SorX14/Tank/Arduino/ControllerBoard_v1/Notes 300814.md

Notes
====

### ESC
- Configuring ESC for forward and backward motion
- Created a configuration mode for the ESCs
- Found the minimum and maximum microseconds of the ESC and set via `Servo.writeMicroseconds()`
- Used servo to help diagnose XRF library

### CRC32 implementation

### Python
