SorX14/Tank/control.jpg

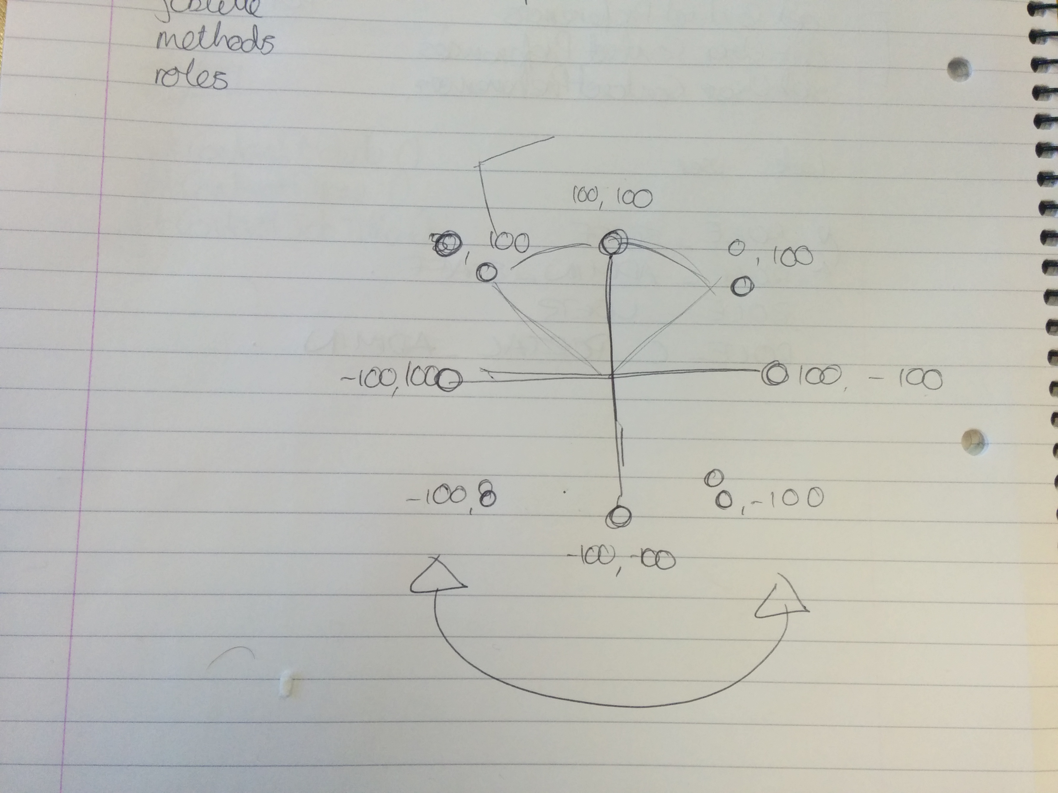
control.jpg
