SorX14/Tank/PCB/Connector board/bottom.png

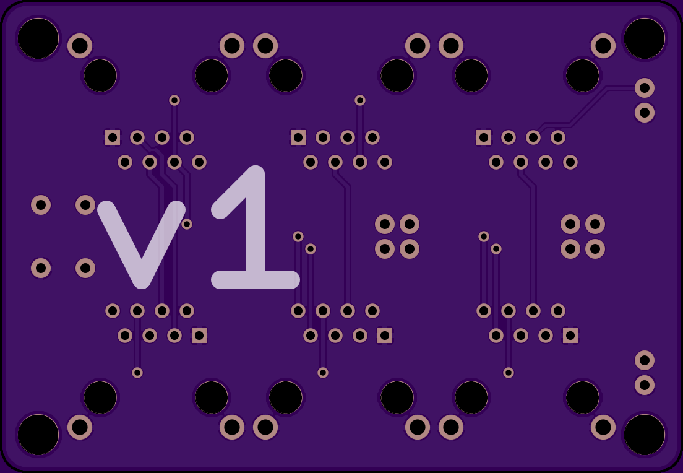
PCB/Connector board/bottom.png
