SorX14/Tank/PCB/Connector board/schematic.png

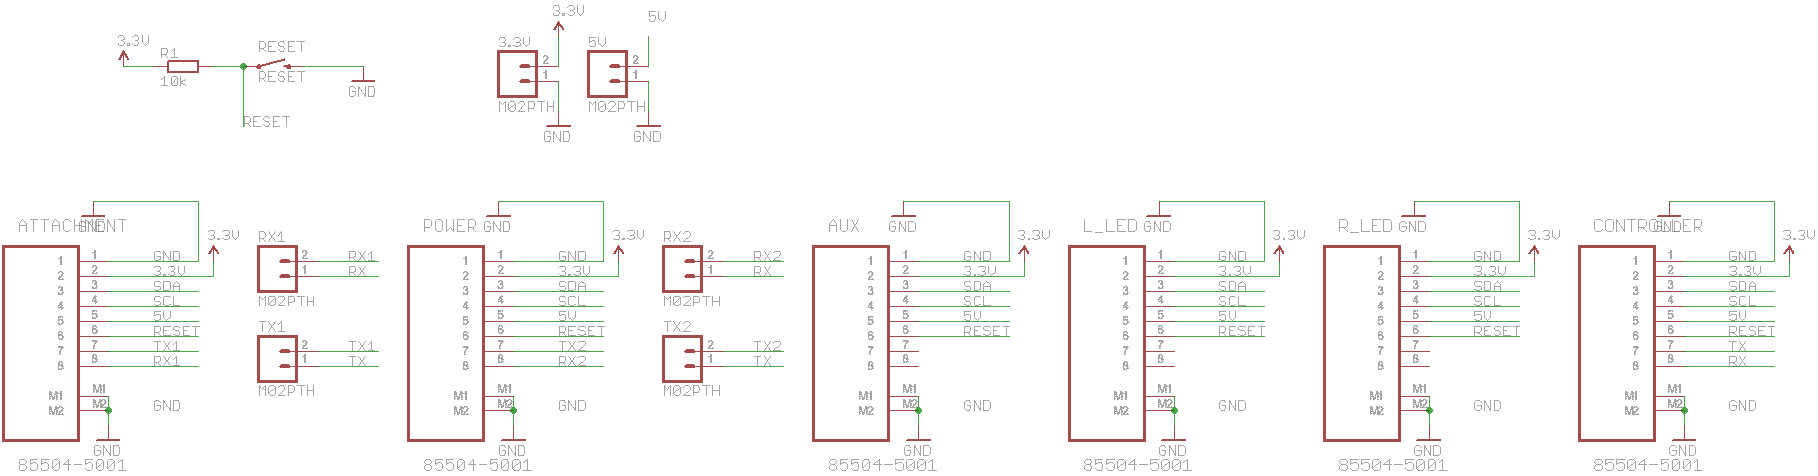
PCB/Connector board/schematic.png
