SorX14/Tank/PCB/Connector board/top.png

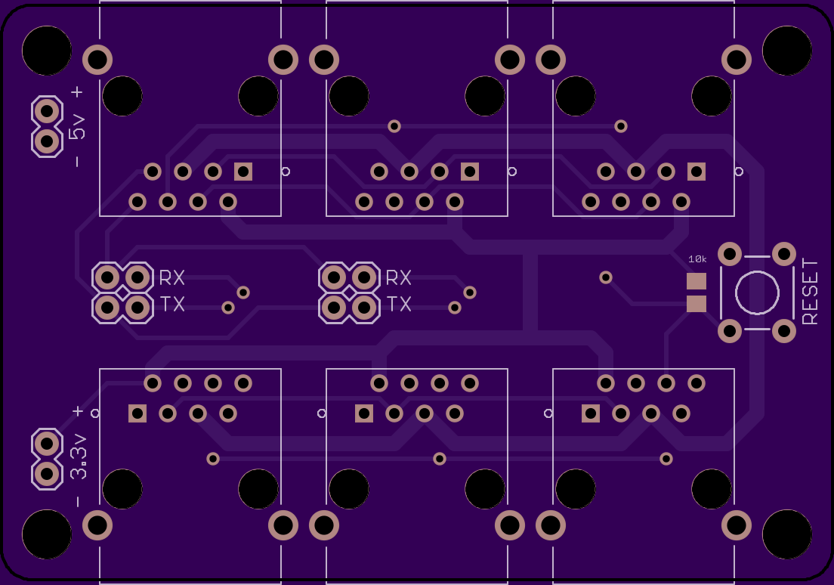
PCB/Connector board/top.png
