SorX14/Tank/PCB/Controller board/bottom.png

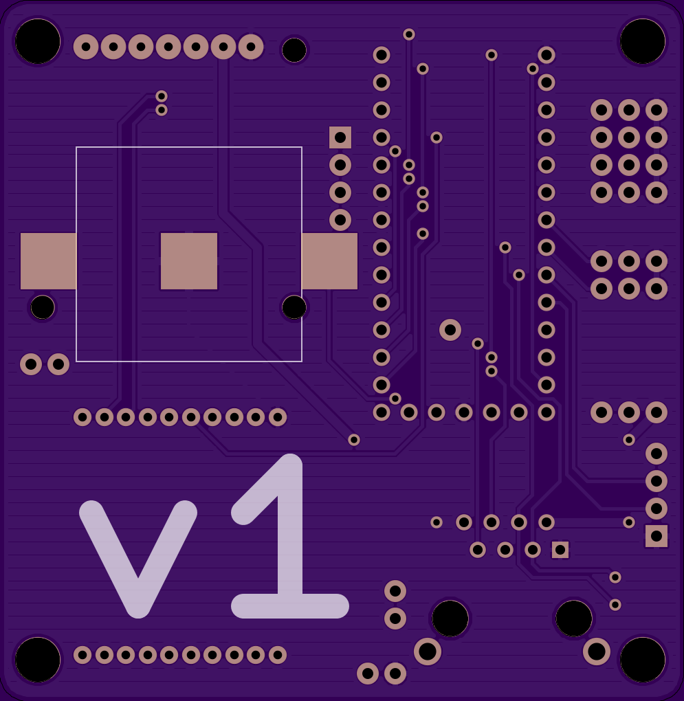
PCB/Controller board/bottom.png
