SorX14/Tank/PCB/Controller board/schematic.png

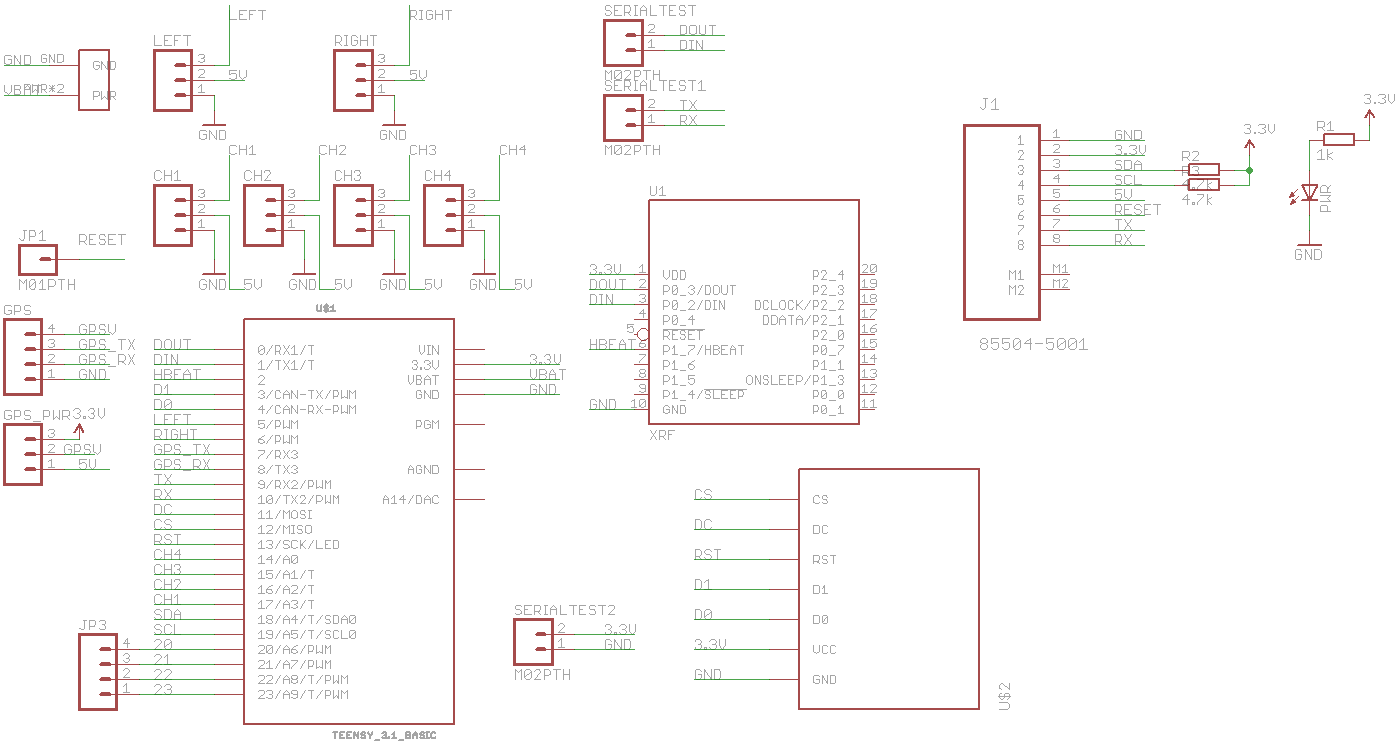
PCB/Controller board/schematic.png
