SorX14/Tank/PCB/Controller board/top.png

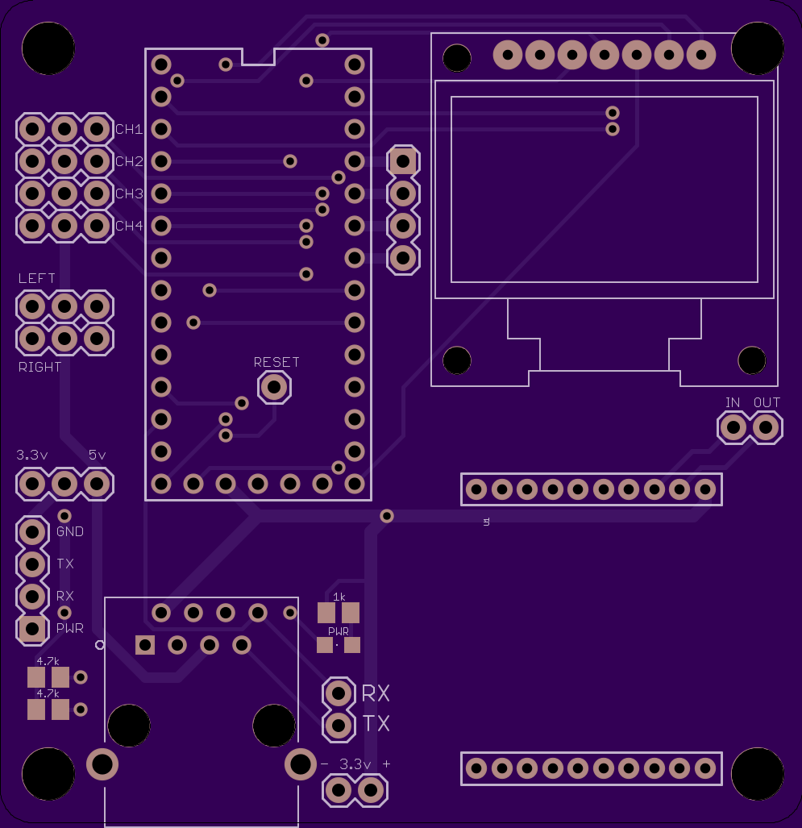
PCB/Controller board/top.png
