SorX14/Tank/PCB/LED board/bottom.png

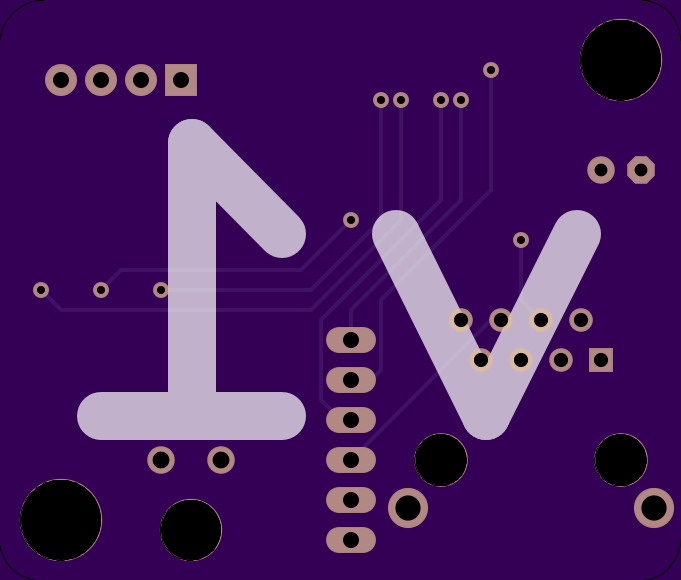
PCB/LED board/bottom.png
