SorX14/Tank/PCB/LED board/schematic.png

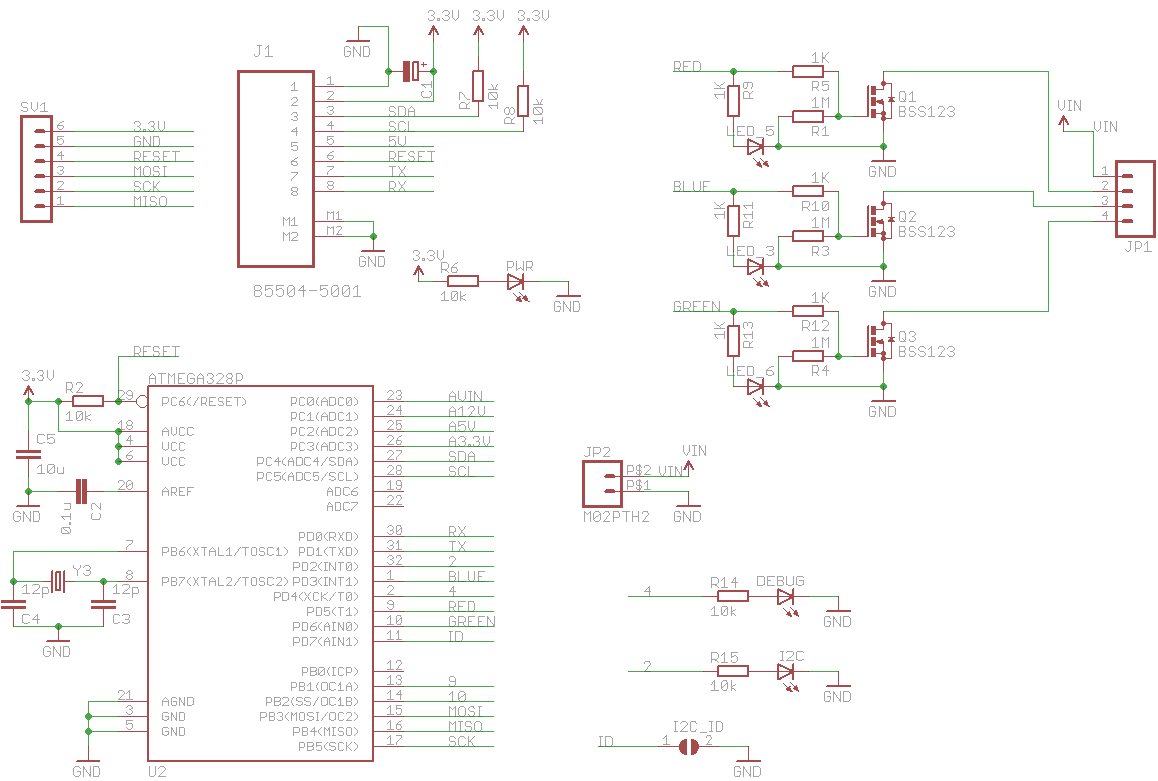
PCB/LED board/schematic.png
