SorX14/Tank/PCB/LED board/top.png

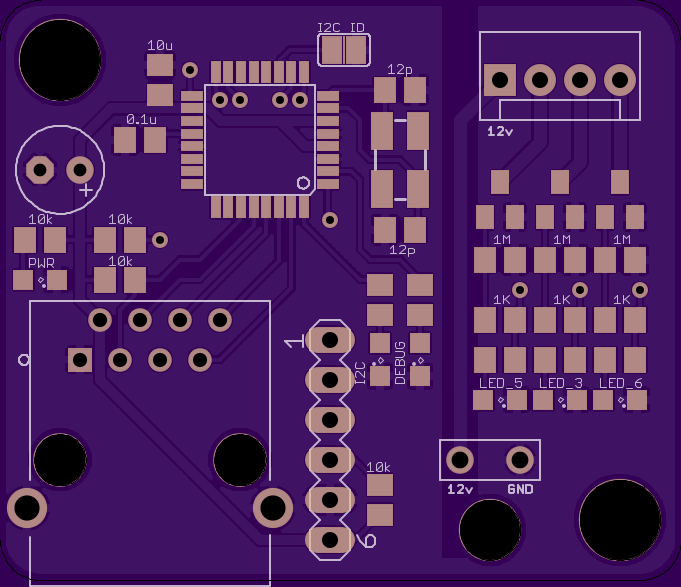
PCB/LED board/top.png
