SorX14/Tank/PCB/Power board/bottom.png

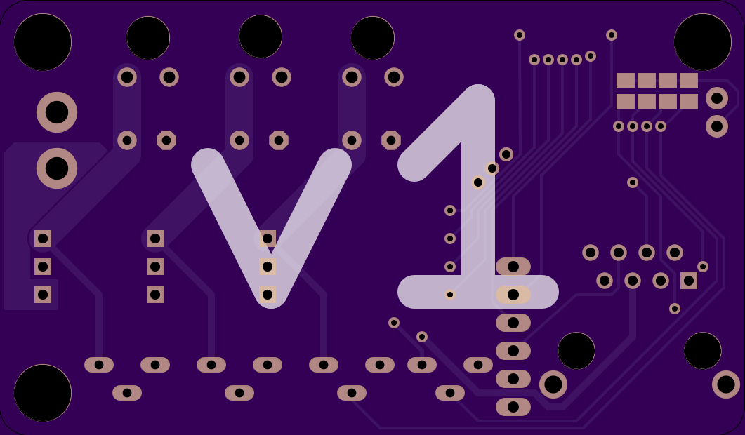
PCB/Power board/bottom.png
