SorX14/Tank/PCB/Power board/schematic.png

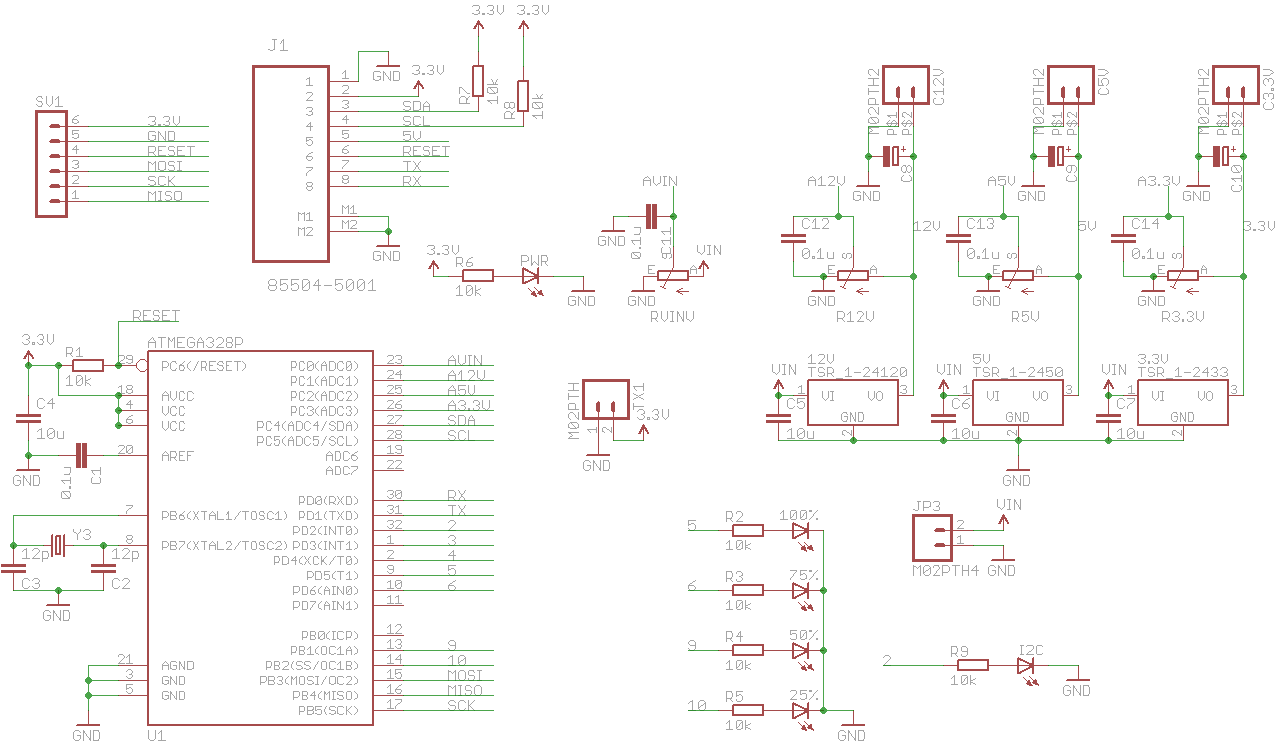
PCB/Power board/schematic.png
