SorX14/Tank/PCB/Power board/top.png

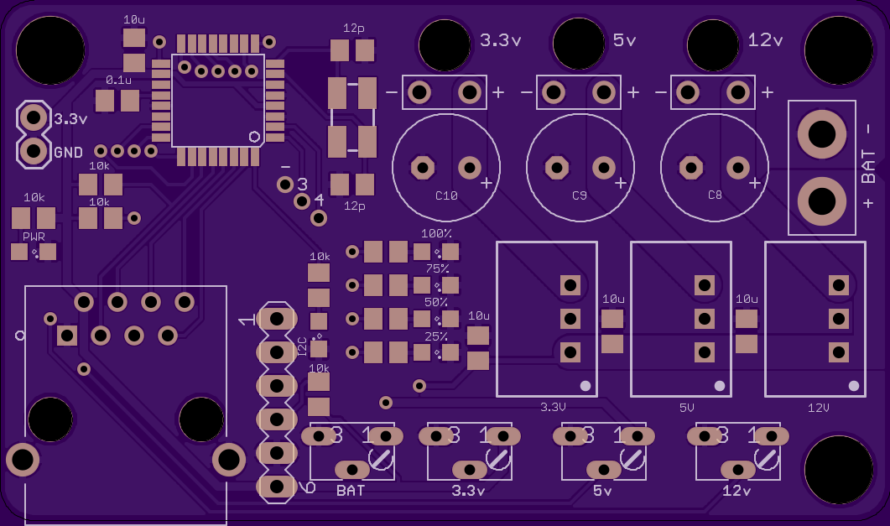
PCB/Power board/top.png
