SorX14/Tank/Arduino/ControllerBoard_v1/ESC calibration.md

ESC calibration
===========

Calibrating Hobbywing XERUN 150A ESC

1. Switch off ESC
2. Hold `SET` key and switch ESC on
	1. Red LED begins to flash
3. Move throttle to **neutral** point and press `SET`
	-  Green LED flashes once
4. Move throttle to 100% **forward** and press `SET`
	- Green LED flashes twice
5. Move throttle to 100% **backward** and press `SET`
	- Green LED flashes three times
6. Throttle range calibration complete, after 3 seconds the ESC is ready to use
