SorX14/Tank/PCB/Connector board/v1.brd

## EAGLE design PCB/Connector board/v1.brd (2014-07-21, an earlier design)

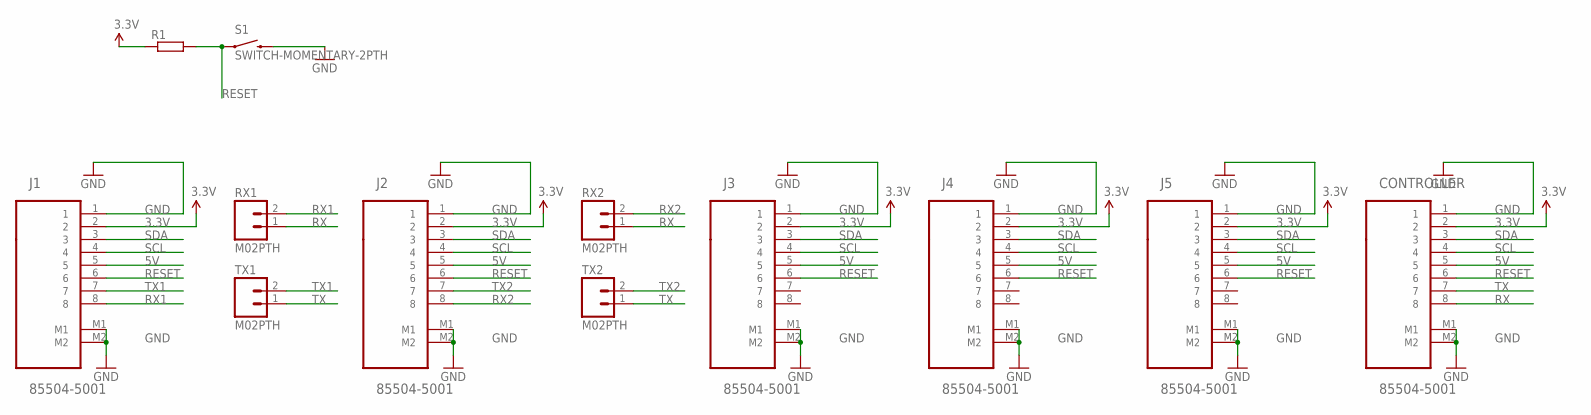
[picture p15: schematic v1.sch]

Parts:
CONTROLLER: 85504-5001; MOLEX_85504-5001
J1, J2, J3, J4, J5: 85504-5001; MOLEX_85504-5001
R1: R-EU_R0805; R0805
RX1, RX2: M02PTH; 1X02
S1: SWITCH-MOMENTARY-2PTH; TACTILE-PTH
TX1, TX2: M02PTH; 1X02

Connections:
3.3V: CONTROLLER.2, J1.2, J2.2, J3.2, J4.2, J5.2, R1.1
5V: CONTROLLER.5, J1.5, J2.5, J3.5, J4.5, J5.5
GND: CONTROLLER.1, CONTROLLER.M1, CONTROLLER.M2, J1.1, J1.M1, J1.M2, J2.1, J2.M1, J2.M2, J3.1, J3.M1, J3.M2, J4.1, J4.M1, J4.M2, J5.1, J5.M1, J5.M2, S1.3 (2)
RESET: CONTROLLER.6, J1.6, J2.6, J3.6, J4.6, J5.6, R1.2, S1.1
RX: CONTROLLER.8, RX1.1, RX2.1
RX1: J1.8, RX1.2
RX2: J2.8, RX2.2
SCL: CONTROLLER.4, J1.4, J2.4, J3.4, J4.4, J5.4
SDA: CONTROLLER.3, J1.3, J2.3, J3.3, J4.3, J5.3
TX: CONTROLLER.7, TX1.1, TX2.1
TX1: J1.7, TX1.2
TX2: J2.7, TX2.2

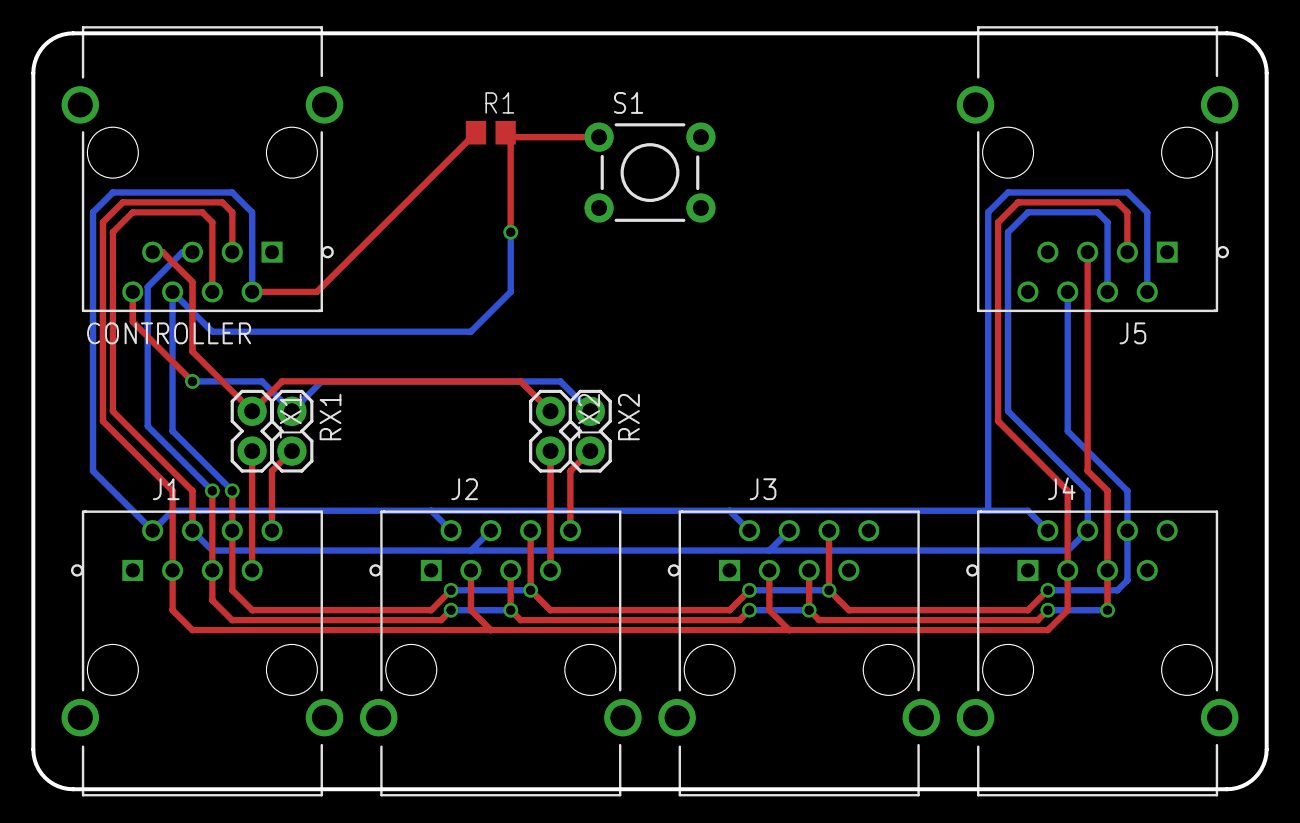
[picture p16: board PCB/Connector board/v1.brd from above]

Board: 2 copper layers, 78.7 x 48.3 mm, 12 parts (0 on the bottom side), 12 nets.
