SorX14/Tank/PCB/Power board/v1.brd

## EAGLE design PCB/Power board/v1.brd (2014-07-21)

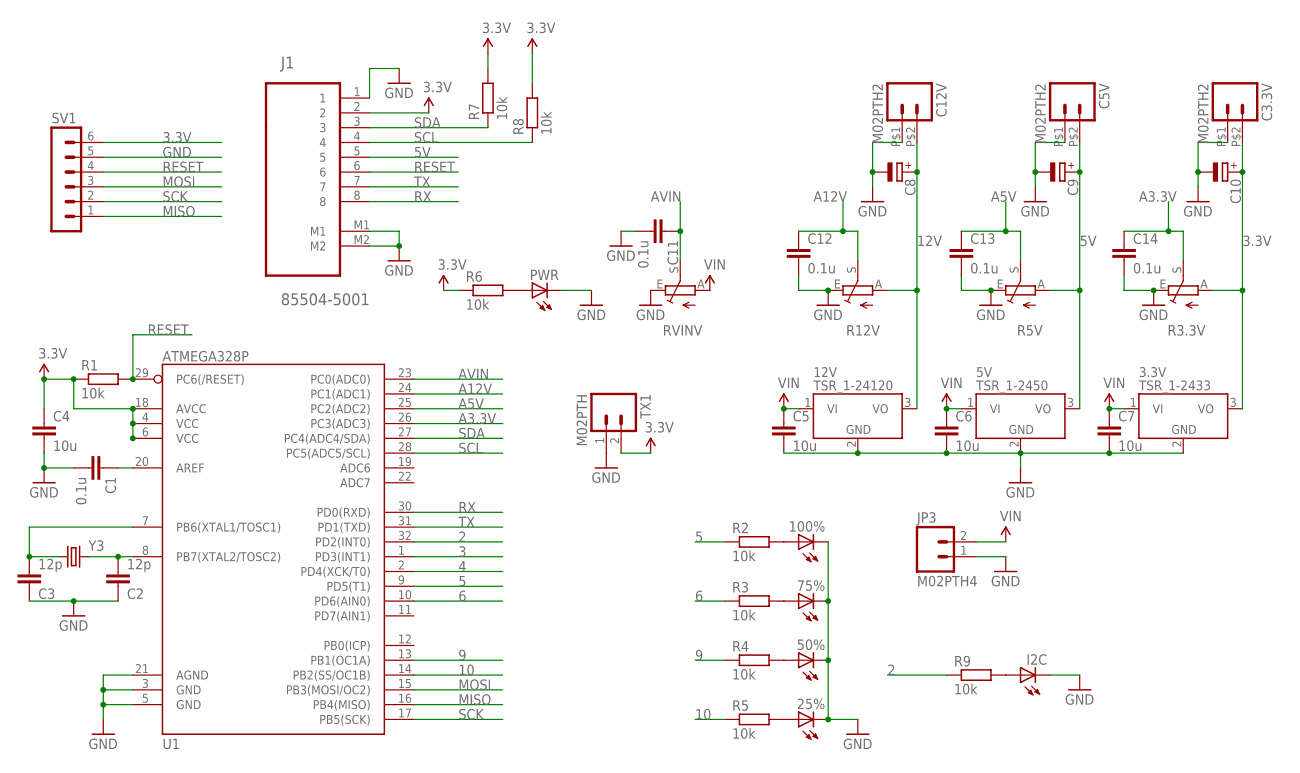
[picture p17: schematic v1.sch]

Parts:
3.3V: TSR_1-2433; TSR-1
5V: TSR_1-2450; TSR-1
12V: TSR_1-24120; TSR-1
25%, 50%, 75%, 100%: LEDSML0805; SML0805
C1, C11, C12, C13, C14: 0.1u; C0805
C2, C3: 12p; C0805
C3.3V, C5V, C12V: M02PTH2; 1X02_BIG
C4, C5, C6, C7: 10u; C0805
C8, C9, C10: CPOL-EUE3.5-8; E3,5-8
I2C: LEDSML0805; SML0805
J1: 85504-5001; MOLEX_85504-5001
JP3: M02PTH4; 1X02_XTRA_BIG
PWR: LEDSML0805; SML0805
R1, R2, R3, R4, R5, R6, R7, R8, R9: 10k; R0805
R3.3V, R5V, R12V: TRIM_EU-B64W; B64W
RVINV: TRIM_EU-B64W; B64W
SV1: MA06-1
TX1: M02PTH; 1X02
U1: ATMEGA328P; TQFP32-08
Y3: CRYSTALCRYSTAL-SMD-5X3-LARGEPAD; CRYSTAL-SMD-5X3

Connections:
2: R9.1, U1.32 (PD2(INT0))
3: U1.1 (PD3(INT1))
3.3V: 3.3V.3 (VO), C3.3V.P$2 (2), C4.1, C10.+, J1.2, R1.1, R3.3V.A, R6.1, R7.2, R8.2, SV1.6, TX1.2, U1.4 (VCC), U1.6 (VCC), U1.18 (AVCC)
4: U1.2 (PD4(XCK/T0))
5: R2.1, U1.9 (PD5(T1))
5V: 5V.3 (VO), C5V.P$2 (2), C9.+, J1.5, R5V.A
6: R3.1, U1.10 (PD6(AIN0))
9: R4.1, U1.13 (PB1(OC1A))
10: R5.1, U1.14 (PB2(SS/OC1B))
12V: 12V.3 (VO), C8.+, C12V.P$2 (2), R12V.A
A3.3V: C14.1, R3.3V.S, U1.26 (PC3(ADC3))
A5V: C13.1, R5V.S, U1.25 (PC2(ADC2))
A12V: C12.1, R12V.S, U1.24 (PC1(ADC1))
AVIN: C11.1, RVINV.S, U1.23 (PC0(ADC0))
GND: 3.3V.2 (GND), 5V.2 (GND), 12V.2 (GND), 25%.C, 50%.C, 75%.C, 100%.C, C1.2, C2.1, C3.1, C3.3V.P$1 (1), C4.2, C5.2, C5V.P$1 (1), C6.2, C7.2, C8.-, C9.-, C10.-, C11.2, C12.2, C12V.P$1 (1), C13.2, C14.2, I2C.C, J1.1, J1.M1, J1.M2, JP3.1, PWR.C, R3.3V.E, R5V.E, R12V.E, RVINV.E, SV1.5, TX1.1, U1.3 (GND), U1.5 (GND), U1.21 (AGND)
MISO: SV1.1, U1.16 (PB4(MISO))
MOSI: SV1.3, U1.15 (PB3(MOSI/OC2))
unnamed: C1.1, U1.20 (AREF)
unnamed: I2C.A, R9.2
unnamed: C2.2, U1.8 (PB7(XTAL2/TOSC2)), Y3.3 (2)
unnamed: C3.2, U1.7 (PB6(XTAL1/TOSC1)), Y3.1
unnamed: 100%.A, R2.2
unnamed: 75%.A, R3.2
unnamed: 50%.A, R4.2
unnamed: 25%.A, R5.2
unnamed: PWR.A, R6.2
RESET: J1.6, R1.2, SV1.4, U1.29 (PC6(/RESET))
RX: J1.8, U1.30 (PD0(RXD))
SCK: SV1.2, U1.17 (PB5(SCK))
SCL: J1.4, R8.1, U1.28 (PC5(ADC5/SCL))
SDA: J1.3, R7.1, U1.27 (PC4(ADC4/SDA))
TX: J1.7, U1.31 (PD1(TXD))
VIN: 3.3V.1 (VI), 5V.1 (VI), 12V.1 (VI), C5.1, C6.1, C7.1, JP3.2, RVINV.A

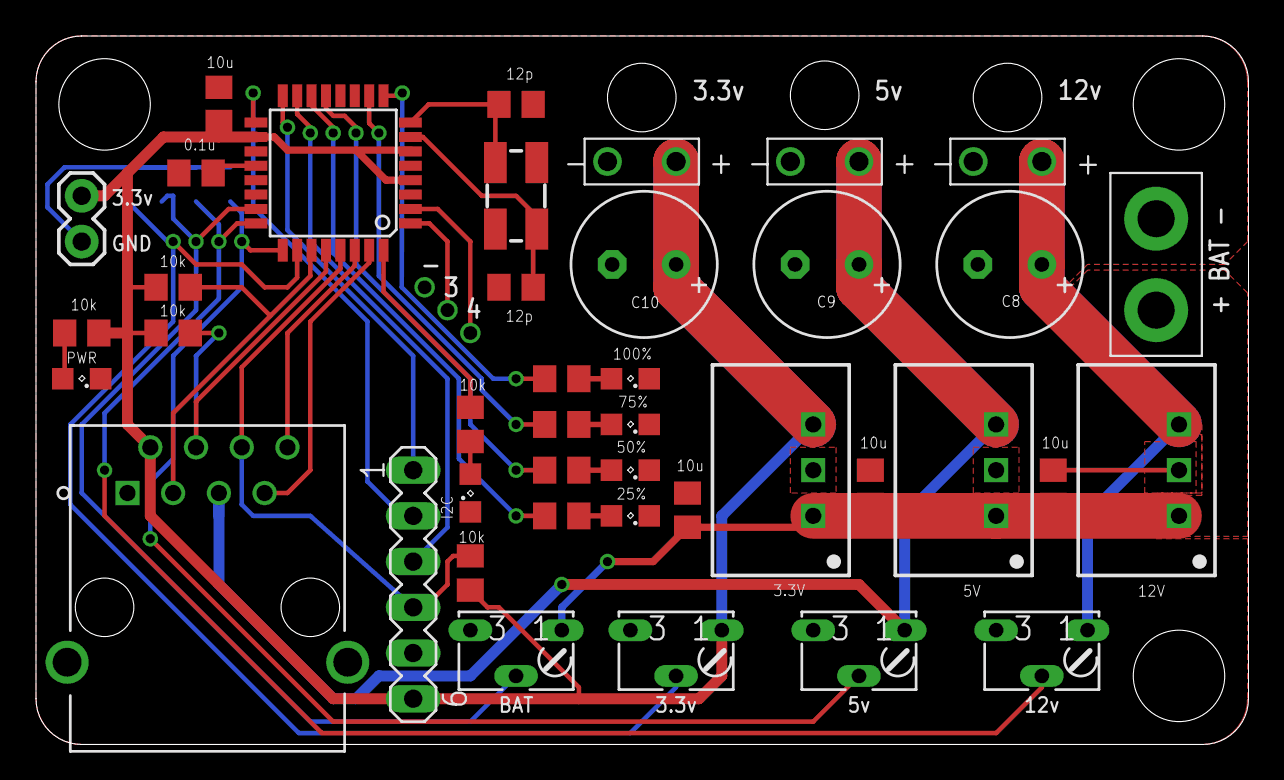
[picture p18: board PCB/Power board/v1.brd from above]

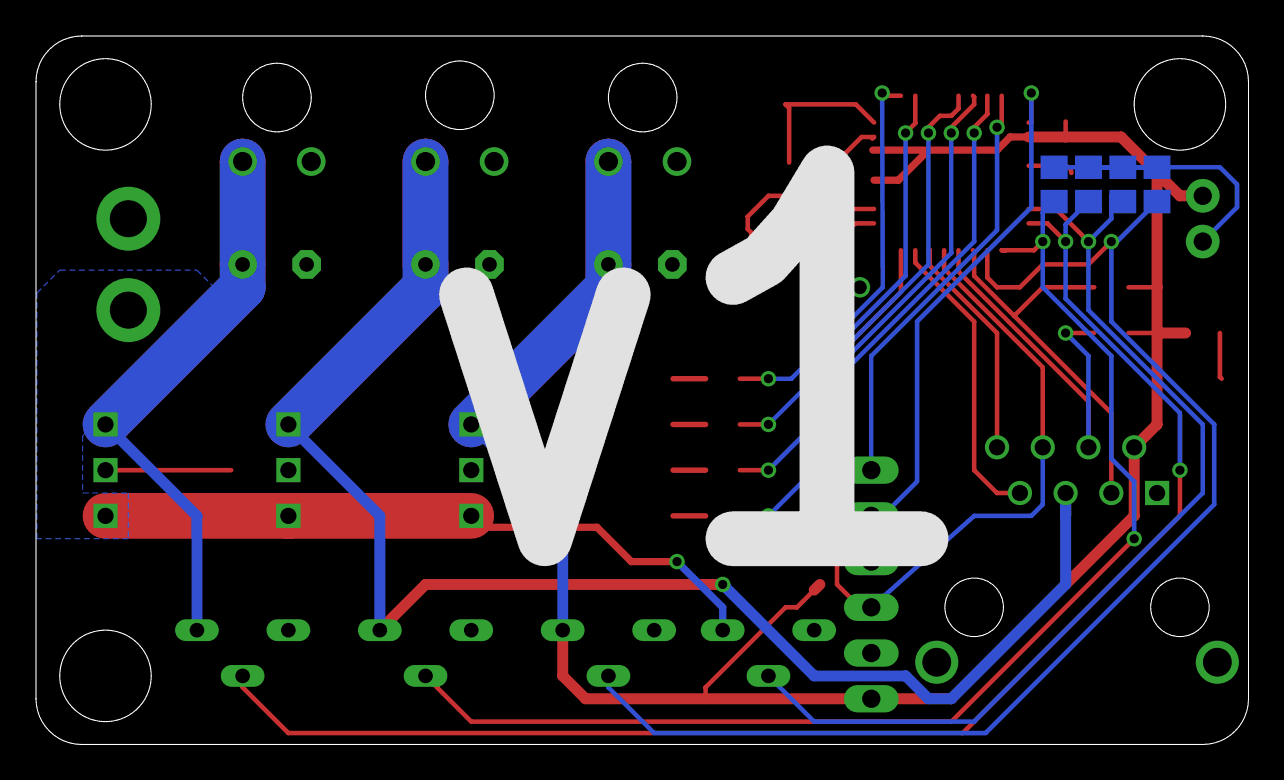
[picture p19: board PCB/Power board/v1.brd from below]

Board: 2 copper layers, 67.4 x 39.4 mm, 45 parts (4 on the bottom side), 31 nets.
