SorX14/Tank/PCB/LED board/v1.brd

## EAGLE design PCB/LED board/v1.brd (2014-07-21)

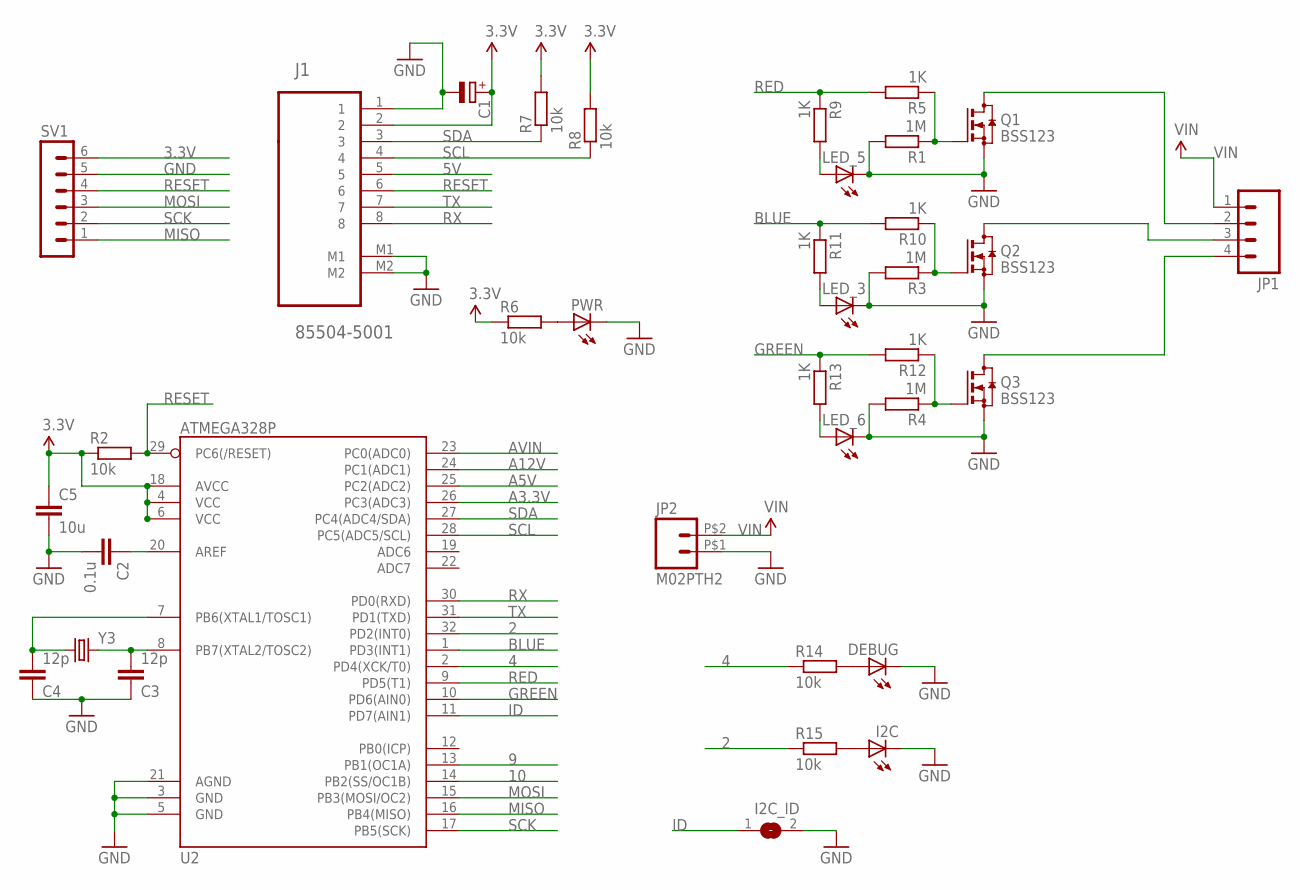
[picture p20: schematic v1.sch]

Parts:
C1: CPOL-EUE2.5-6; E2,5-6
C2: 0.1u; C0805
C3, C4: 12p; C0805
C5: 10u; C0805
DEBUG: LEDSML0805; SML0805
I2C: LEDSML0805; SML0805
I2C_ID: SJ
J1: 85504-5001; MOLEX_85504-5001
JP1: M04POLAR; MOLEX-1X4
JP2: M02PTH2; 1X02_BIG
LED_3, LED_5, LED_6: LEDSML0805; SML0805
PWR: LEDSML0805; SML0805
Q1, Q2, Q3: BSS123; SOT23
R1, R3, R4: 1M; R0805
R2, R6, R7, R8, R14, R15: 10k; R0805
R5, R9, R10, R11, R12, R13: 1K; R0805
SV1: MA06-1
U2: ATMEGA328P; TQFP32-08
Y3: CRYSTALCRYSTAL-SMD-5X3-LARGEPAD; CRYSTAL-SMD-5X3

Connections:
2: R15.1, U2.32 (PD2(INT0))
3.3V: C1.+, C5.1, J1.2, R2.1, R6.1, R7.2, R8.2, SV1.6, U2.4 (VCC), U2.6 (VCC), U2.18 (AVCC)
4: R14.1, U2.2 (PD4(XCK/T0))
5V: J1.5
9: U2.13 (PB1(OC1A))
10: U2.14 (PB2(SS/OC1B))
A3.3V: U2.26 (PC3(ADC3))
A5V: U2.25 (PC2(ADC2))
A12V: U2.24 (PC1(ADC1))
AVIN: U2.23 (PC0(ADC0))
BLUE: R10.2, R11.1, U2.1 (PD3(INT1))
GND: C1.-, C2.2, C3.1, C4.1, C5.2, DEBUG.C, I2C.C, I2C_ID.2, J1.1, J1.M1, J1.M2, JP2.P$1 (1), LED_3.C, LED_5.C, LED_6.C, PWR.C, Q1.2 (S), Q2.2 (S), Q3.2 (S), R1.2, R3.2, R4.2, SV1.5, U2.3 (GND), U2.5 (GND), U2.21 (AGND)
GREEN: R12.2, R13.1, U2.10 (PD6(AIN0))
ID: I2C_ID.1, U2.11 (PD7(AIN1))
MISO: SV1.1, U2.16 (PB4(MISO))
MOSI: SV1.3, U2.15 (PB3(MOSI/OC2))
unnamed: JP1.2, Q1.3 (D)
unnamed: C2.1, U2.20 (AREF)
unnamed: C3.2, U2.8 (PB7(XTAL2/TOSC2)), Y3.3 (2)
unnamed: C4.2, U2.7 (PB6(XTAL1/TOSC1)), Y3.1
unnamed: JP1.3, Q2.3 (D)
unnamed: JP1.4, Q3.3 (D)
unnamed: Q1.1 (G), R1.1, R5.1
unnamed: Q2.1 (G), R3.1, R10.1
unnamed: Q3.1 (G), R4.1, R12.1
unnamed: DEBUG.A, R14.2
unnamed: PWR.A, R6.2
unnamed: I2C.A, R15.2
unnamed: LED_5.A, R9.2
unnamed: LED_3.A, R11.2
unnamed: LED_6.A, R13.2
RED: R5.2, R9.1, U2.9 (PD5(T1))
RESET: J1.6, R2.2, SV1.4, U2.29 (PC6(/RESET))
RX: J1.8, U2.30 (PD0(RXD))
SCK: SV1.2, U2.17 (PB5(SCK))
SCL: J1.4, R8.1, U2.28 (PC5(ADC5/SCL))
SDA: J1.3, R7.1, U2.27 (PC4(ADC4/SDA))
TX: J1.7, U2.31 (PD1(TXD))
VIN: JP1.1, JP2.P$2 (2)

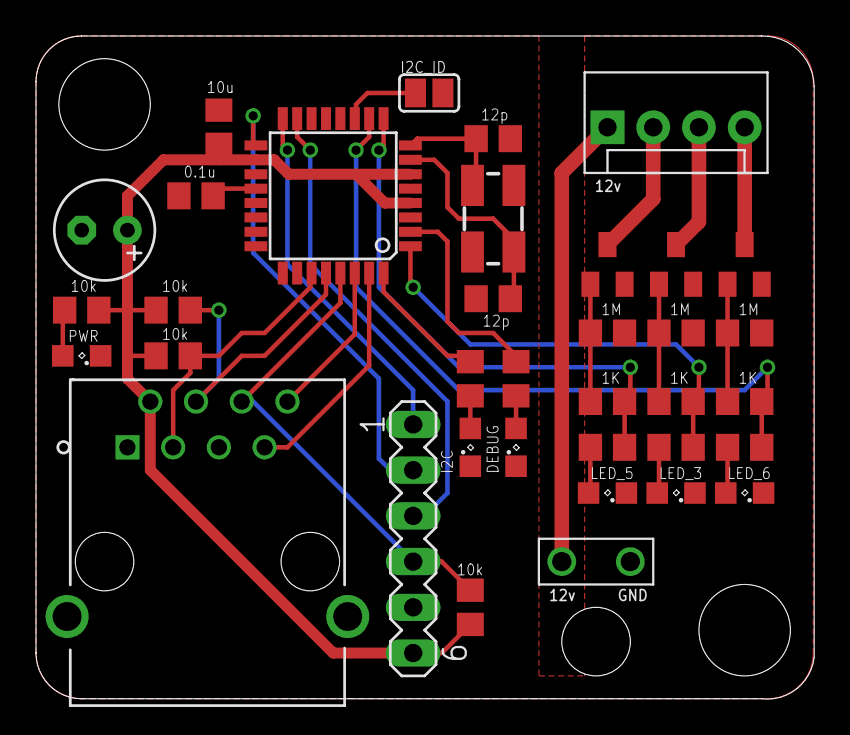
[picture p21: board PCB/LED board/v1.brd from above]

Board: 2 copper layers, 43.2 x 36.8 mm, 36 parts (0 on the bottom side), 32 nets.
