SorX14/Tank/PCB/Connector board/v2.brd

## EAGLE design PCB/Connector board/v2.brd (2014-07-21)

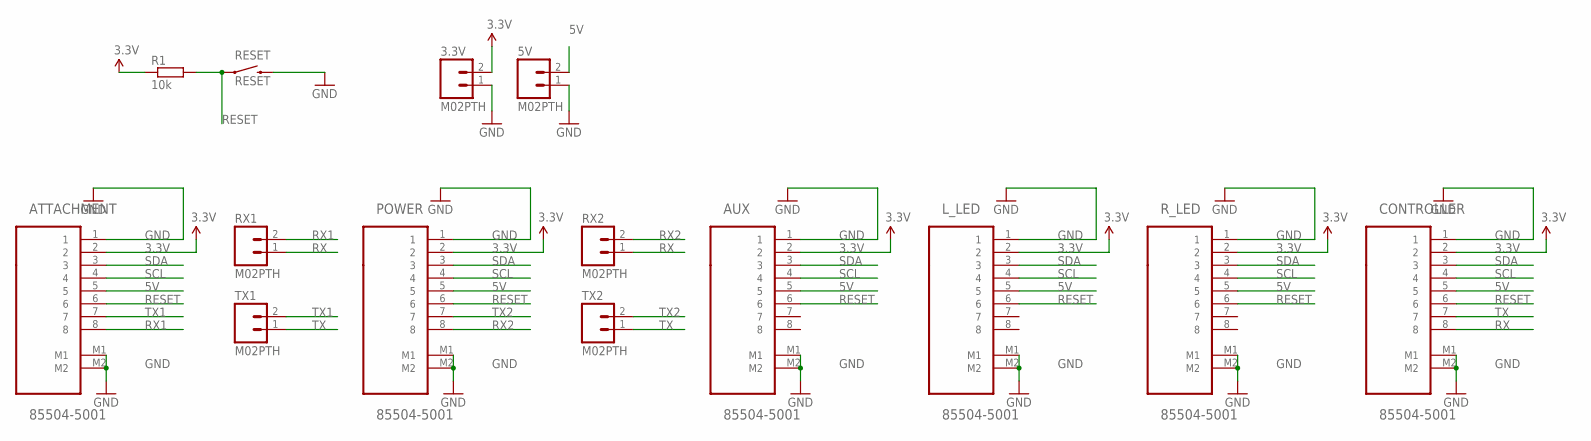
[picture p22: schematic v2.sch]

Parts:
3.3V, 5V: M02PTH; 1X02
ATTACHMENT: 85504-5001; MOLEX_85504-5001
AUX: 85504-5001; MOLEX_85504-5001
CONTROLLER: 85504-5001; MOLEX_85504-5001
L_LED: 85504-5001; MOLEX_85504-5001
POWER: 85504-5001; MOLEX_85504-5001
R1: 10k; R0805
RESET: RESET; TACTILE-PTH
RX1, RX2: M02PTH; 1X02
R_LED: 85504-5001; MOLEX_85504-5001
TX1, TX2: M02PTH; 1X02

Connections:
3.3V: 3.3V.2, ATTACHMENT.2, AUX.2, CONTROLLER.2, L_LED.2, POWER.2, R1.1, R_LED.2
5V: 5V.2, ATTACHMENT.5, AUX.5, CONTROLLER.5, L_LED.5, POWER.5, R_LED.5
GND: 3.3V.1, 5V.1, ATTACHMENT.1, ATTACHMENT.M1, ATTACHMENT.M2, AUX.1, AUX.M1, AUX.M2, CONTROLLER.1, CONTROLLER.M1, CONTROLLER.M2, L_LED.1, L_LED.M1, L_LED.M2, POWER.1, POWER.M1, POWER.M2, RESET.3 (2), R_LED.1, R_LED.M1, R_LED.M2
RESET: ATTACHMENT.6, AUX.6, CONTROLLER.6, L_LED.6, POWER.6, R1.2, RESET.1, R_LED.6
RX: CONTROLLER.8, RX1.1, RX2.1
RX1: ATTACHMENT.8, RX1.2
RX2: POWER.8, RX2.2
SCL: ATTACHMENT.4, AUX.4, CONTROLLER.4, L_LED.4, POWER.4, R_LED.4
SDA: ATTACHMENT.3, AUX.3, CONTROLLER.3, L_LED.3, POWER.3, R_LED.3
TX: CONTROLLER.7, TX1.1, TX2.1
TX1: ATTACHMENT.7, TX1.2
TX2: POWER.7, TX2.2

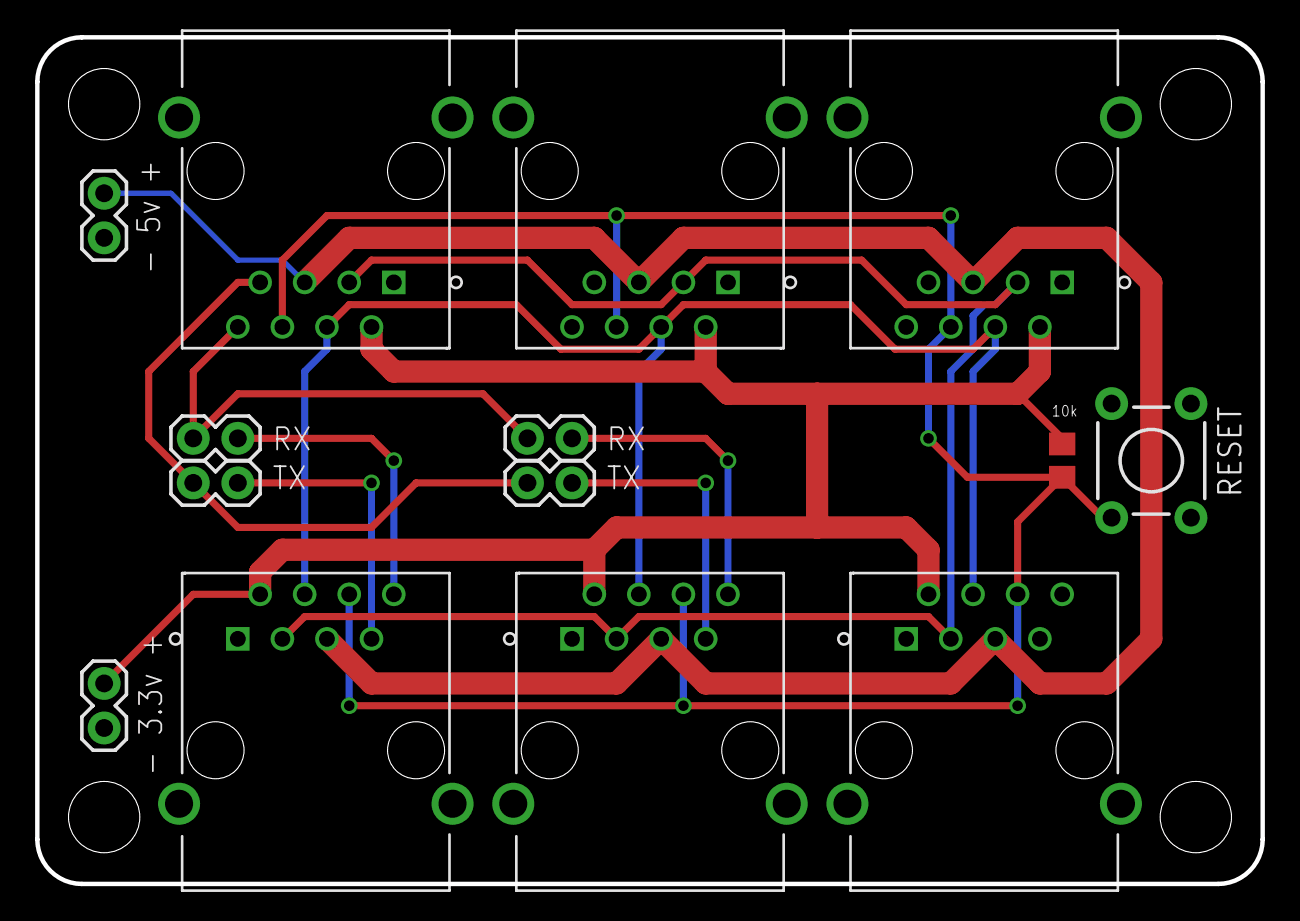
[picture p23: board v2.brd from above]

Board: 2 copper layers, 69.8 x 48.3 mm, 14 parts (0 on the bottom side), 12 nets.
