SorX14/Tank/Arduino/ControllerBoard_v1/pins.h

#ifndef pins_h
#define pins_h

#include <Arduino.h>

// Define the pins for the OLED display
#define OLED_MOSI   3
#define OLED_CLK   4
#define OLED_DC    11
#define OLED_CS    12
#define OLED_RESET 13
// Create images with LCD assistant; Byte orientation Horizontal, make monochrome bitmap

// Pins used to connect to the RC receiver
#define RC1PIN 17
#define RC2PIN 16
#define RC3PIN 15
#define RC4PIN 14

#define RESET 27

// Setup the DC brushless pins
#define PWMA 5
#define PWMB 6
#define AIN2 23
#define AIN1 22
#define BIN1 21
#define BIN2 20



#endif
