SorX14/Tank/Arduino/ControllerBoard_v1/movement.ino

/*
Actually drive the various motors depending on their type
 move* accepts a value between -255 and 255 and either drives the track forward or backward
 */

#define DC_PWM_MIN 50
#define DC_PWM_MAX 255

#define RC_NEUTRAL_MAX 150
#define RC_NEUTRAL_MIN 106

#if defined(BRUSHED_DRIVE_METHOD)

void setParkingBrake(bool position) {
  parking_brake = position;

  // Update the XRF object
  xrf.movement.setParkingBrake(position);
}

// Accepts a value negative/positive 255, 0 is neutral
void setLeft(int value) {
  // Set the XRF object data
  xrf.movement.setRequestedSpeedLeft(value);

  int pwm_actual = 0;

  if (value > 0) {
    // Forward
    digitalWrite(AIN1, HIGH);
    digitalWrite(AIN2, LOW);

    pwm_actual = map(value, 0, 255, 0, 255);
  } 
  else if (value < 255) {
    // Reverse
    digitalWrite(AIN1, LOW);
    digitalWrite(AIN2, HIGH);

    pwm_actual = map(value, 0, -255, 0, 255);
  } 
  else {
    // Stop
    digitalWrite(AIN1, LOW);
    digitalWrite(AIN2, LOW);
    pwm_actual = 0;
  }

  // If the parking brake is enabled, or the PWM value is less than the minimum
  // PWM value of the motor
  if (parking_brake || pwm_actual < DC_PWM_MIN) {
    pwm_actual = 0;
  }				

  // Set the XRF object data
  if (value < 0) {
    xrf.movement.setLiveSpeedLeft(-pwm_actual);
  } 
  else {
    xrf.movement.setLiveSpeedLeft(pwm_actual);
  }

  analogWrite(PWMA, pwm_actual);
}

void setRight(int value) {
  // Set the XRF object data
  xrf.movement.setRequestedSpeedRight(value);

  int pwm_actual = 0;

  if (value > 0) {
    // Forward
    digitalWrite(BIN2, HIGH);
    digitalWrite(BIN1, LOW);

    pwm_actual = map(value, 0, 255, 0, 255);
  } 
  else if (value < 255) {
    // Reverse
    digitalWrite(BIN2, LOW);
    digitalWrite(BIN1, HIGH);

    pwm_actual = map(value, 0, -255, 0, 255);
  } 
  else {
    // Stop
    digitalWrite(BIN1, LOW);
    digitalWrite(BIN2, LOW);
    pwm_actual = 0;
  }

  // If the parking brake is enabled, or the PWM value is less than the minimum
  // PWM value of the motor
  if (parking_brake || pwm_actual < DC_PWM_MIN) {
    pwm_actual = 0;
  }				

  // Set the XRF object data
  if (value < 0) {
    xrf.movement.setLiveSpeedRight(-pwm_actual);
  } 
  else {
    xrf.movement.setLiveSpeedRight(pwm_actual);
  }

  analogWrite(PWMB, pwm_actual);
}


#else
void setLeft(int pwm_value) {
  xrf.movement.setRequestedSpeedLeft(pwm_value);
  left_pwm_value = map(pwm_value, -255, 255, 0, 180);

  xrf.movement.setLiveSpeedLeft(left_pwm_value);
  //  left.write(left_pwm_value);
  writeLeft(left_pwm_value);
}

void setRight(int pwm_value) {
  xrf.movement.setRequestedSpeedRight(pwm_value);
  right_pwm_value = map(pwm_value, -255, 255, 0, 180);

  xrf.movement.setLiveSpeedRight(right_pwm_value);
  //  right.write(right_pwm_value);
  writeRight(right_pwm_value);
}

void setParkingBrake(bool position) {
  parking_brake = position;

  // Update the XRF object
  xrf.movement.setParkingBrake(position);
}

void writeLeft(int pwm_value) {
  if (parking_brake) {
    a = 90;
  }

  //  int a = map(pwm_value, 0, 180, ESC_MIN, ESC_MAX);  
  int a = map(pwm_value, 180, 0, ESC_MIN, ESC_MAX); // Invert while testing
  left.writeMicroseconds(a);
}

void writeRight(int pwm_value) {
  if (parking_brake) {
    a = 90;
  }

  int a = map(pwm_value, 0, 180, ESC_MIN, ESC_MAX);
  right.writeMicroseconds(a);
}
#endif
