SorX14/Tank/(commit log)

2014-07-21 Readme for LED board
2014-07-21 Adding PCB
2014-07-21 Adding tilt compensation
    [v1.brd]
2014-07-21 Adding voltage low-pass filtering
2014-07-22 I2C improvements
    Updated hasComms method to include the IMU
    Improved the layout and structure of the IMU acquisition code
    Improved commenting
2014-07-29 Fixed IMU issues (signed not unsigned int)
    [ControllerBoard_v1.ino, VoltageBoard_v1.ino, functions.ino, gps.ino, i2c_functions.ino, icons.h, imu.ino, interrupts.ino]
2014-08-04 PCB images and RC control
    Added OSH Park renders of the PCBs, updated the code to allow control
    via RC
2014-08-04 Updated documentation with PCB images
2014-08-06 Adding XRF library and framerate
2014-08-12 Add schematic images
